lsb71620/LandingGear-Moto-Arduino-R4/LandingGearMoto_ArduinoNanoR4.pdf

IP- | IP+
BTS7960 Gauche | BTS7960 Droite

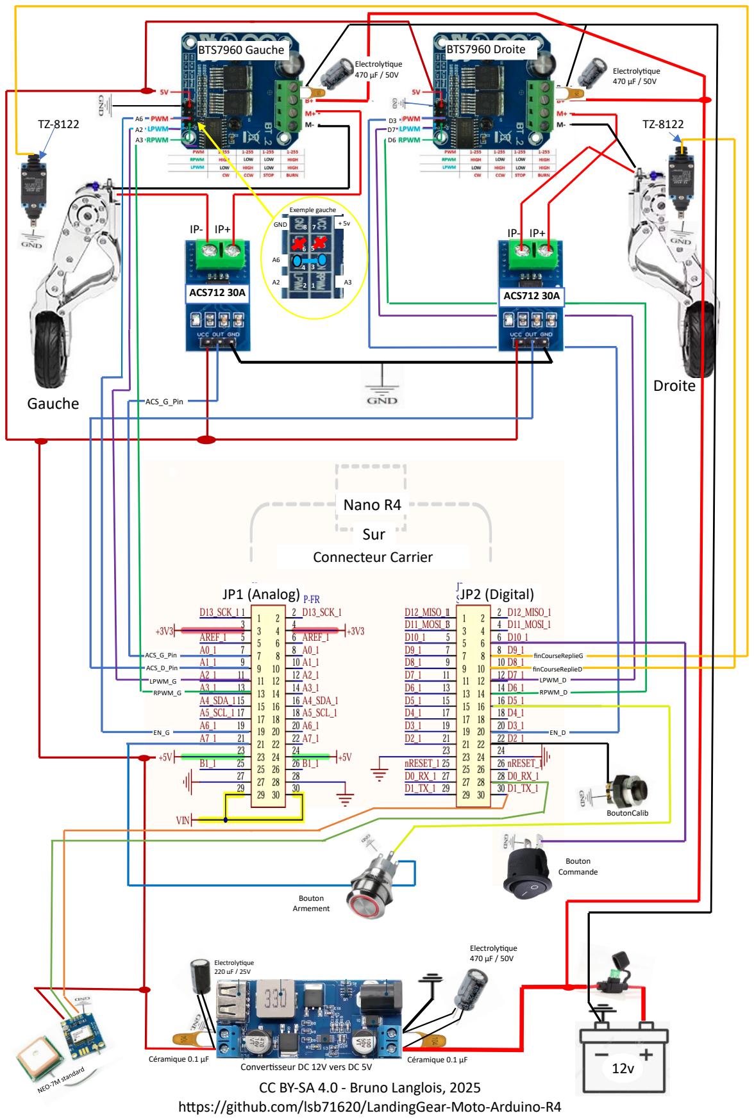
[picture p7: page 1]
ACS_G_Pin; ACS_D_Pin; Céramique 0.1 µF; Electrolytique 470 µF / 50V; Electrolytique 220 µF / 25V; Nano R4; ACS712 30A; Gauche; Droite; Sur; Bouton Commande; Bouton Armement; JP1 (Analog); JP2 (Digital); LPWM_G; finCourseReplieG; Exemple gauche; GND; finCourseReplieD; RPWM_G; RPWM_D; LPWM_D; BoutonCalib; Connecteur Carrier

Convertisseur DC 12V vers DC 5V
CC BY-SA 4.0 - Bruno Langlois, 2025

https://github.com/lsb71620/LandingGear-Moto-Arduino-R4
